Shya-Bubu/pocket-fm-radio/images/v2_working_2.png

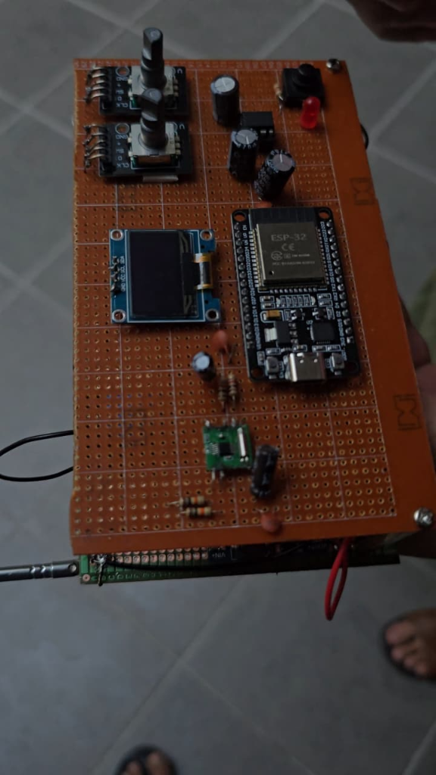
images/v2_working_2.png
