Shya-Bubu/pocket-fm-radio/radio 2.kicad_pcb

## KiCad design radio 2.kicad_pcb (2026-09-21)

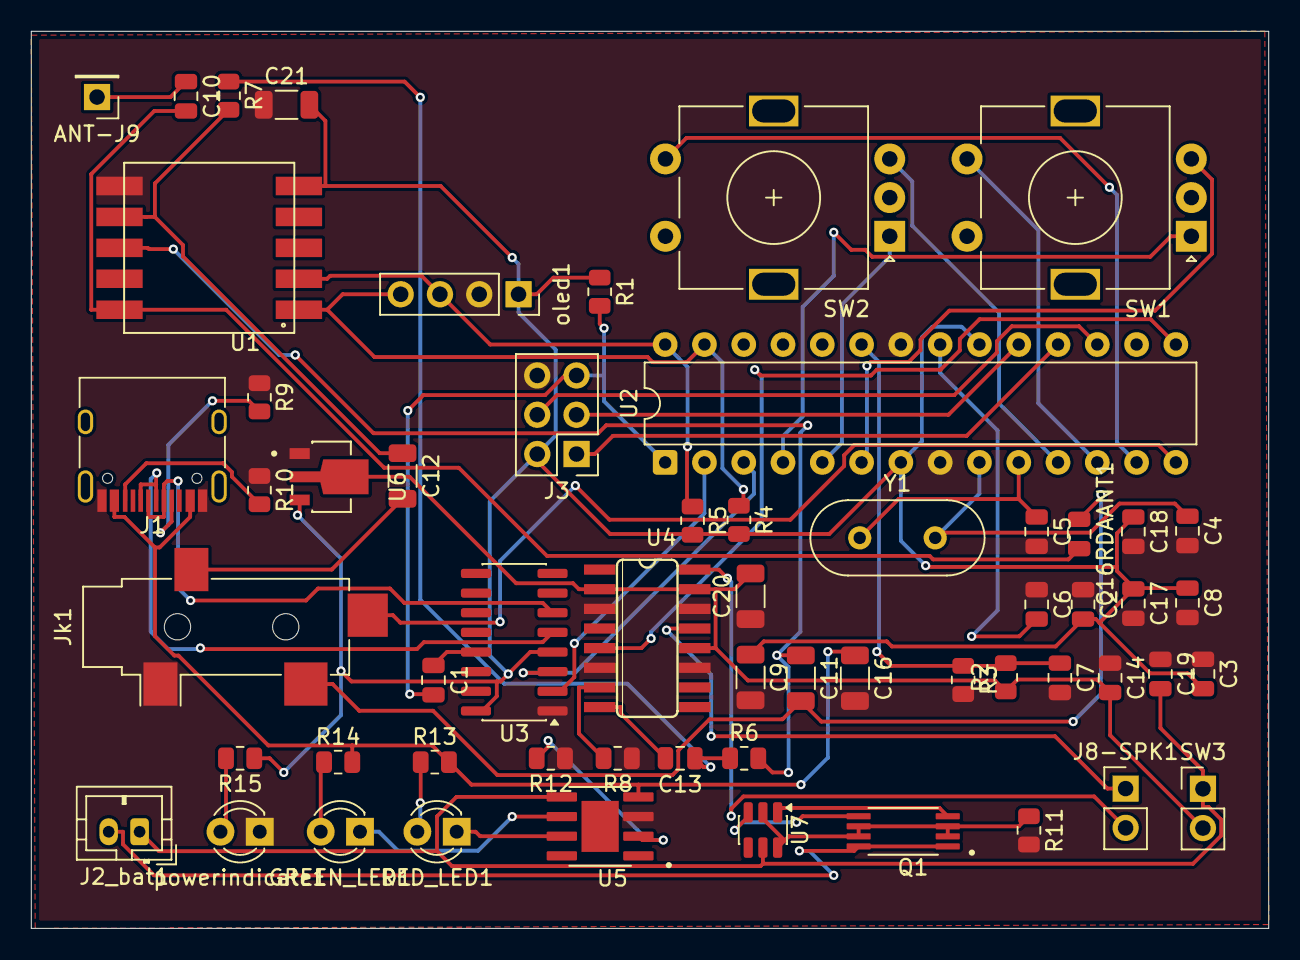
[picture p22: board radio 2.kicad_pcb from above]

Board: 2 copper layers, 80.0 x 58.0 mm, 58 parts (0 on the bottom side), 51 nets.

Parts:
ANT-J9: Conn_01x01; PinHeader_1x01_P2.54mm_Vertical
C1, C2, C3, C6, C7, C8, C14, C17, C18: 100nF; C_0805_2012Metric
C4, C5: 22pF; C_0805_2012Metric
C9, C11, C12, C16, C20, C21: 10uF; C_1206_3216Metric
C10, C16RDAANT1: 100pF; C_0805_2012Metric
C13, C19: 1uF; C_0805_2012Metric
GREEN_LED1: LED; LED_D3.0mm
J1: USB_C_Receptacle_USB2.0_16P; USB_C_Receptacle_HRO_TYPE-C-31-M-12
J2_bat1: Conn_01x02; JST_PH_B2B-PH-K_1x02_P2.00mm_Vertical
J3: Conn_02x03_Counter_Clockwise; PinHeader_2x03_P2.54mm_Vertical
J8-SPK1: Conn_01x02; PinHeader_1x02_P2.54mm_Vertical
Jk1: AudioJack3_SwitchT; Jack_3.5mm_CUI_SJ-3524-SMT_Horizontal
Q1: FS8205A; SOP65P640X120-8N
R1, R6, R7, R8: 10k; R_0805_2012Metric
R2, R3: 100k; R_0805_2012Metric
R4, R5: 4.7k; R_0805_2012Metric
R9, R10: 5.1k; R_0805_2012Metric
R11: 100; R_0805_2012Metric
R12: 2.2k; R_0805_2012Metric
R13, R14: 1k; R_0805_2012Metric
R15: 330; R_0805_2012Metric
RED_LED1: LED; LED_D3.0mm
SW1, SW2: RotaryEncoder_Switch; RotaryEncoder_Alps_EC11E-Switch_Vertical_H20mm
SW3: SW_SPST; PinHeader_1x02_P2.54mm_Vertical
U1: RDA5807M
U2: ATMEGA328P-PU; DIP-28_W7.62mm
U3: CH340C; SOIC-16_3.9x9.9mm_P1.27mm
U4: PAM8403; SOP-16
U5: TP4056; SOP127P600X175-9N
U6: HT7333; IC_HT7333
U7: DW01A; SOT-23-6
Y1: Crystal; Crystal_HC49-4H_Vertical
oled1: Conn_01x04; PinSocket_1x04_P2.54mm_Vertical
powerindicate1: LED; LED_D3.0mm

Connections:
+3V3: C2.2, C3.2, C8.1, C9.1, C17.1, C18.1, C21.2, J3.2, R1.1, R4.2, R5.2, R15.1, U1.VCC, U2.7 (VCC), U2.20 (AVCC), U3.4 (V3), U3.16 (VCC), U6.3 (VOUT), oled1.1
/1: R4.1, U1.SDA, U2.27 (PC4), oled1.4
/2: R5.1, U1.SCL, U2.28 (PC5), oled1.3
/6: C10.2, C16RDAANT1.2, U1.ANT
/8: C11.1, R6.2, U1.L (LOUT)
/9: C12.1, R7.2, U1.R (ROUT)
/VBAT: C14.2, C20.2, R2.1, SW3.2 (B), U4.2 (PVCC), U4.12 (VCC), U4.15 (PVCC), U6.2 (VIN)
GND: C2.1, C3.1, C4.2, C5.2, C6.1, C7.2, C8.2, C9.2, C14.1, C16.2, C17.2, C18.2, C19.1, C20.1, C21.1, J1.A1 (GND), J1.A12 (GND), J1.B1 (GND), J1.B12 (GND), J3.6, Jk1.S, R3.2, R8.1, R9.1, R10.1, R11.2, R12.1, U1.GND, U2.8 (GND), U2.22 (GND), U3.1 (GND), U4.3 (PGND), U4.6 (PGND), U4.11 (GND), U4.14 (PGND), U5.3 (GND), U6.1 (GND), oled1.2, powerindicate1.1 (K)
unnamed: ANT-J9.1, C10.1
unnamed: C11.2, C16RDAANT1.1, Jk1.T
unnamed: C12.2, Jk1.R
unnamed: C13.1, R6.1, R7.1
unnamed: GREEN_LED1.2 (A), R14.1
unnamed: GREEN_LED1.1 (K), U5.6 (~STDBY)
unnamed: J1.A5 (CC1), R9.2
unnamed: J1.B5 (CC2), R10.2
unnamed: C19.2, J2_bat1.1, SW3.1 (A), U5.5 (BAT), U7.5 (VCC)
unnamed: J2_bat1.2, Q1.1, Q1.8
unnamed: J3.1, U2.18 (PB4)
unnamed: J3.3, U2.19 (PB5)
unnamed: J3.4, U2.17 (PB3)
unnamed: C1.2, J3.5, R1.2, U2.1 (PC6/~RESET)
unnamed: J8-SPK1.1, U4.13 (OUTL-)
unnamed: J8-SPK1.2, U4.16 (OUTL+)
unnamed: R13.1, RED_LED1.2 (A)
unnamed: RED_LED1.1 (K), U5.7 (~CHRG)
unnamed: C6.2, U2.21 (AREF)
unnamed: Jk1.TN, U2.14 (PB0)
unnamed: U2.15 (PB1), U4.5 (~SHDN)
unnamed: C4.1, U2.9 (PB6), Y1.2
unnamed: C5.1, U2.10 (PB7), Y1.1
unnamed: C7.1, R2.2, R3.1, U2.23 (PC0)
unnamed: U2.2 (PD0), U3.2 (TXD)
unnamed: U2.3 (PD1), U3.3 (RXD)
unnamed: SW1.A, U2.4 (PD2)
unnamed: SW2.A, U2.5 (PD3)
unnamed: SW1.B, U2.6 (PD4)
unnamed: SW2.B, U2.11 (PD5)
unnamed: SW1.S1, U2.12 (PD6)
unnamed: SW2.S1, U2.13 (PD7)
unnamed: J1.A6 (D+), J1.B6 (D+), U3.5 (UD+)
unnamed: J1.A7 (D-), J1.B7 (D-), U3.6 (UD-)
unnamed: C1.1, U3.13 (~DTR)
unnamed: C13.2, U4.8 (INL)
unnamed: R8.2, U4.7 (INR)
unnamed: R12.2, U5.2 (PROG)
unnamed: C16.1, J1.A4 (VBUS), J1.A9 (VBUS), J1.B4 (VBUS), J1.B9 (VBUS), R13.2, R14.2, U5.4 (VCC)
unnamed: Q1.2, Q1.3, Q1.6, Q1.7, R11.1, U7.2 (CS), U7.6 (GND)
unnamed: Q1.5, U7.3 (OC)
unnamed: Q1.4, U7.1 (OD)
unnamed: R15.2, powerindicate1.2 (A)
