Shya-Bubu/pocket-fm-radio/(commit log)

2026-09-21 Initial commit: FM Pocket Radio Design & Report
    [ESP32_FM_Radio_V2.kicad_pcb, ESP32_FM_Radio_V2.kicad_sch, kicad radio.kicad_pcb, kicad radio.kicad_sch, radio 2.kicad_pcb]
2026-09-21 Clean up unused KiCad folders, keep actual radio 2.kicad_pcb
    [ESP32_FM_Radio_V2.kicad_pcb, ESP32_FM_Radio_V2.kicad_sch, kicad radio.kicad_pcb, kicad radio.kicad_sch]
2026-10-16 Crop prototype image, center images in README, remove author footer
